sphereinabox/sixteen-nine-sao-2026/kicad/v1/sixteen-nine-sao/fab/bom.csv

Comment | Designator | Footprint | LCSC
LED | D1,DA1,DA2,DA3,DA4,DA5,DA6,DA7,DA8,DA9,DA10,DA11,DA12,DA13,DA14,DA15,DA16,DA17,DA18,DA19,DA20,DA21,DA22,DA23,DA24,DA25,DA26,DA27,DA28,DA29,DA30,DA31,DA32,DA33,DA34,DA35,DA36,DA37,DA38,DA39,DA40,DA41,DA42,DA43,DA44,DA45,DA46,DA47,DA48,DA49,DA50,DA51,DA52,DA53,DA54,DA55,DA56,DA57,DA58,DA59,DA60,DA61,DA62,DA63,DA64,DA65,DA66,DA67,DA68,DA69,DA70,DA71,DA72,DB1,DB2,DB3,DB4,DB5,DB6,DB7,DB8,DB9,DB10,DB11,DB12,DB13,DB14,DB15,DB16,DB17,DB18,DB19,DB20,DB21,DB22,DB23,DB24,DB25,DB26,DB27 | LED_SMD:LED_0603_1608Metric | C2290
LED | DB28,DB29,DB30,DB31,DB32,DB33,DB34,DB35,DB36,DB37,DB38,DB39,DB40,DB41,DB42,DB43,DB44,DB45,DB46,DB47,DB48,DB49,DB50,DB51,DB52,DB53,DB54,DB55,DB56,DB57,DB58,DB59,DB60,DB61,DB62,DB63,DB64,DB65,DB66,DB67,DB68,DB69,DB70,DB71,DB72 | LED_SMD:LED_0603_1608Metric | C2290
20k | R1,R4,R5,R6,R7,R8 | Resistor_SMD:R_0603_1608Metric | C4184
IS31FL3731-QF | U1 | Package_DFN_QFN:QFN-28-1EP_4x4mm_P0.4mm_EP2.3x2.3mm | C191206
100pF | C2,C5 | Capacitor_SMD:C_0402_1005Metric | C1546
150R | R9 | Resistor_SMD:R_0603_1608Metric | C22808
CH32V003F4U6 | U2 | Package_DFN_QFN:QFN-20-1EP_3x3mm_P0.4mm_EP1.65x1.65mm | C5299908
220pF | C1 | Capacitor_SMD:C_0402_1005Metric | C1530
10uF | C3,C4 | Capacitor_SMD:C_0603_1608Metric | C19702
100nF | C6 | Capacitor_SMD:C_0402_1005Metric | C1525
SW_Push | SW1,SW2 | Button_Switch_SMD:SW_SPST_TS-1088-xR020 | C720477
300R | R2,R3 | Resistor_SMD:R_0603_1608Metric | C23025
