sphereinabox/sixteen-nine-sao-2026/kicad/v1/sixteen-nine-sao/sixteen-nine-sao.csv

Reference | Qty | Value | LCSC | Footprint | Exclude from BOM | Exclude from Board | Exclude from Simulation | Exclude from Position Files | DNP
C1 | 1 | 220pF | C1530 | Capacitor_SMD:C_0402_1005Metric |  |  |  | ${EXCLUDE_FROM_POS_FILES}
C2,C5 | 2 | 100pF | C1546 | Capacitor_SMD:C_0402_1005Metric |  |  |  | ${EXCLUDE_FROM_POS_FILES}
C3,C4 | 2 | 10uF | C19702 | Capacitor_SMD:C_0603_1608Metric |  |  |  | ${EXCLUDE_FROM_POS_FILES}
C6 | 1 | 100nF | C1525 | Capacitor_SMD:C_0402_1005Metric |  |  |  | ${EXCLUDE_FROM_POS_FILES}
D1,DA1,DA2,DA3,DA4,DA5,DA6,DA7,DA8,DA9,DA10,DA11,DA12,DA13,DA14,DA15,DA16,DA17,DA18,DA19,DA20,DA21,DA22,DA23,DA24,DA25,DA26,DA27,DA28,DA29,DA30,DA31,DA32,DA33,DA34,DA35,DA36,DA37,DA38,DA39,DA40,DA41,DA42,DA43,DA44,DA45,DA46,DA47,DA48,DA49,DA50,DA51,DA52,DA53,DA54,DA55,DA56,DA57,DA58,DA59,DA60,DA61,DA62,DA63,DA64,DA65,DA66,DA67,DA68,DA69,DA70,DA71,DA72,DB1,DB2,DB3,DB4,DB5,DB6,DB7,DB8,DB9,DB10,DB11,DB12,DB13,DB14,DB15,DB16,DB17,DB18,DB19,DB20,DB21,DB22,DB23,DB24,DB25,DB26,DB27,DB28,DB29,DB30,DB31,DB32,DB33,DB34,DB35,DB36,DB37,DB38,DB39,DB40,DB41,DB42,DB43,DB44,DB45,DB46,DB47,DB48,DB49,DB50,DB51,DB52,DB53,DB54,DB55,DB56,DB57,DB58,DB59,DB60,DB61,DB62,DB63,DB64,DB65,DB66,DB67,DB68,DB69,DB70,DB71,DB72 | 145 | LED | C2290 | LED_SMD:LED_0603_1608Metric |  |  |  | ${EXCLUDE_FROM_POS_FILES}
J1 | 1 | Conn_02x03_Odd_Even |  | Connector_IDC:IDC-Header_2x03_P2.54mm_Vertical |  |  |  | ${EXCLUDE_FROM_POS_FILES} | DNP
J3 | 1 | Conn_01x06_Pin |  | Connector_PinHeader_2.00mm:PinHeader_1x06_P2.00mm_Vertical |  |  |  | ${EXCLUDE_FROM_POS_FILES} | DNP
R1,R4,R5,R6,R7,R8 | 6 | 20k | C4184 | Resistor_SMD:R_0603_1608Metric |  |  |  | ${EXCLUDE_FROM_POS_FILES}
R2,R3 | 2 | 300R | C23025 | Resistor_SMD:R_0603_1608Metric |  |  |  | ${EXCLUDE_FROM_POS_FILES}
R9 | 1 | 150R | C22808 | Resistor_SMD:R_0603_1608Metric |  |  |  | ${EXCLUDE_FROM_POS_FILES}
SW1,SW2 | 2 | SW_Push | C720477 | Button_Switch_SMD:SW_SPST_TS-1088-xR020 |  |  |  | ${EXCLUDE_FROM_POS_FILES}
U1 | 1 | IS31FL3731-QF | C191206 | Package_DFN_QFN:QFN-28-1EP_4x4mm_P0.4mm_EP2.3x2.3mm |  |  |  | ${EXCLUDE_FROM_POS_FILES}
U2 | 1 | CH32V003F4U6 | C5299908 | Package_DFN_QFN:QFN-20-1EP_3x3mm_P0.4mm_EP1.65x1.65mm |  |  |  | ${EXCLUDE_FROM_POS_FILES}
