sphereinabox/sixteen-nine-sao-2026/kicad/v1/schematic.pdf

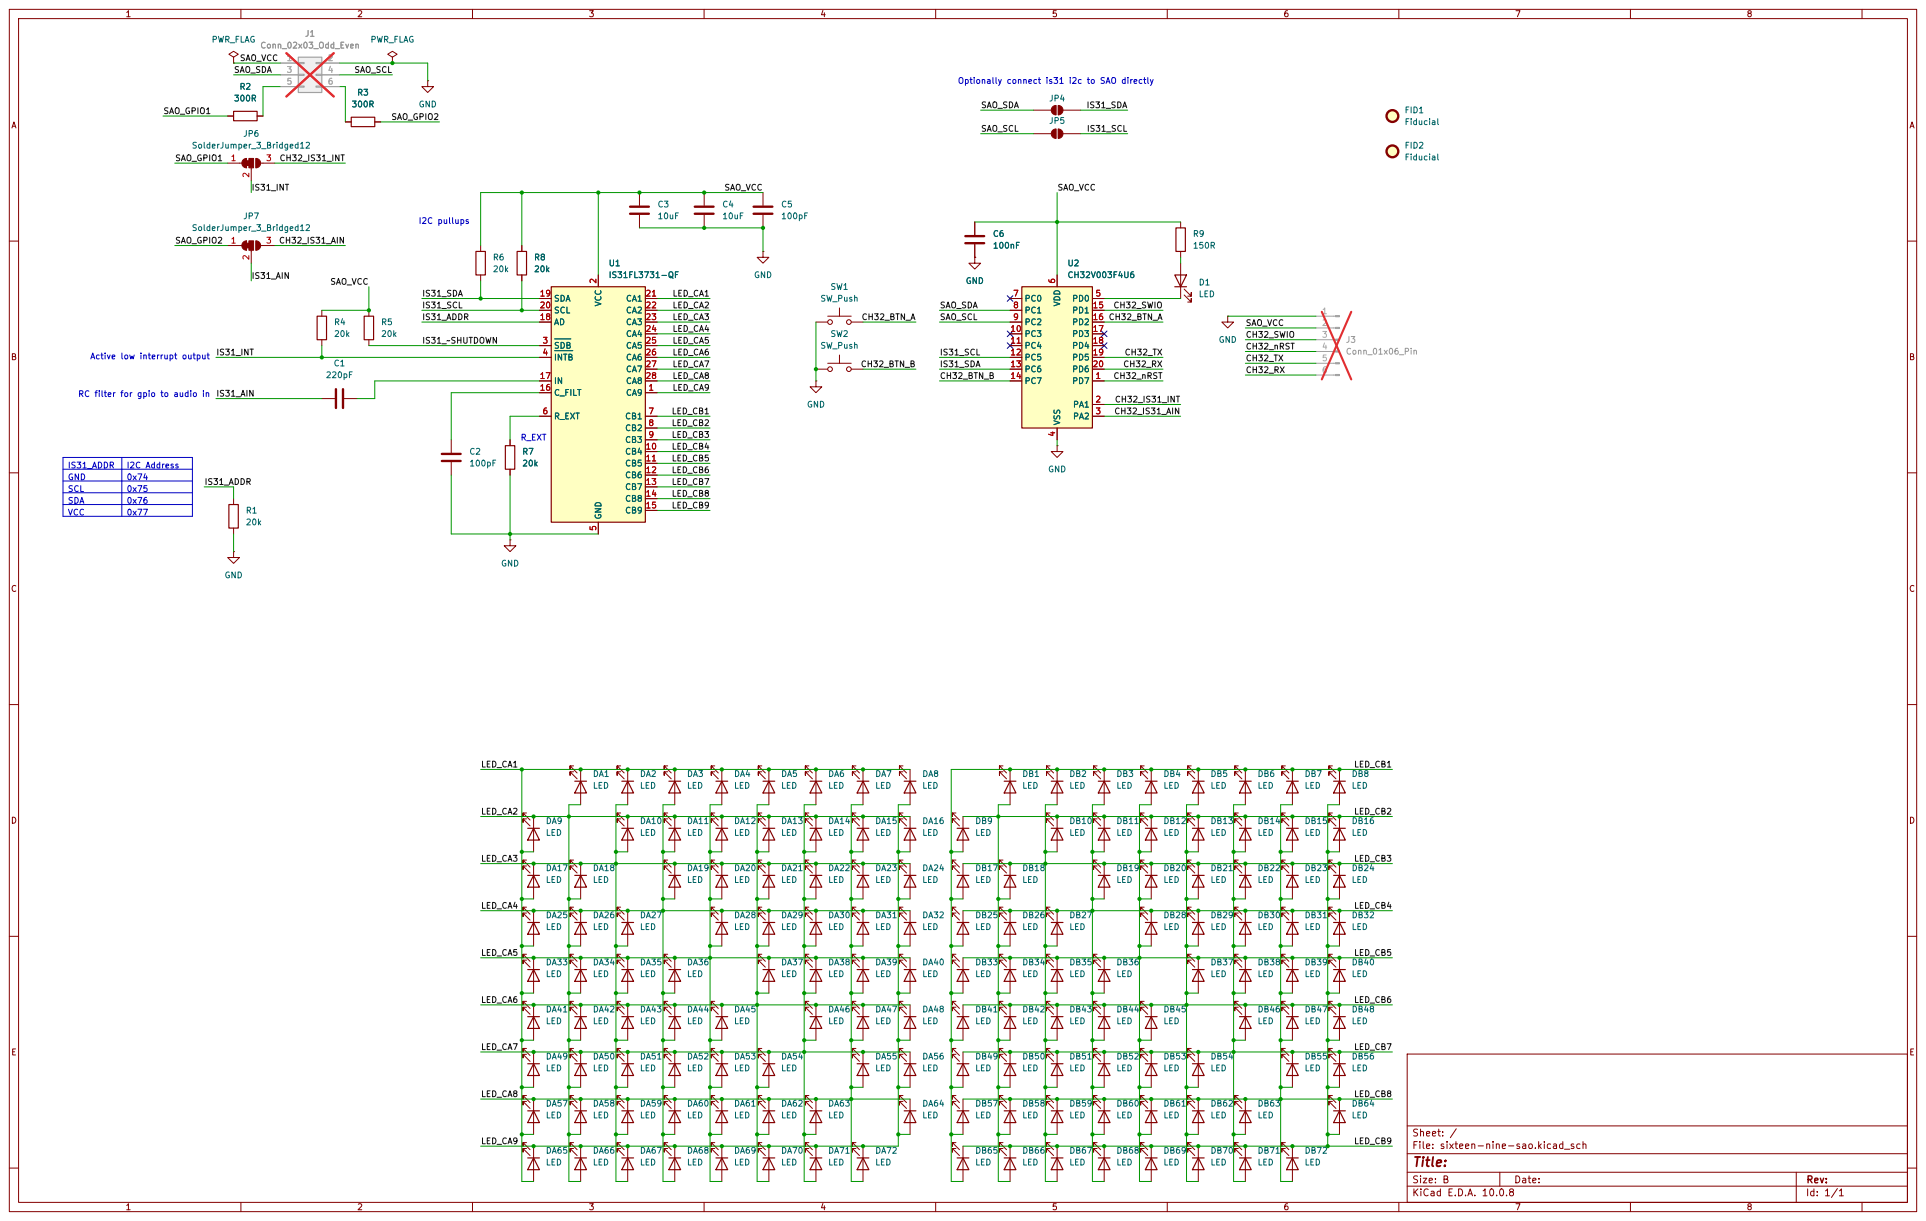
[picture p3: page 1]

IS31_ADDR | I2C Address GND 0x74

SCL | 0x75
SDA | 0x76

Sheet: /
File: sixteen-nine-sao.kicad_sch
Title:

Size: B | Rev:
KiCad E.D.A. 10.0.8 | Id: 1/1
