sphereinabox/sixteen-nine-sao-2026/kicad/v1/sixteen-nine-sao.pdf

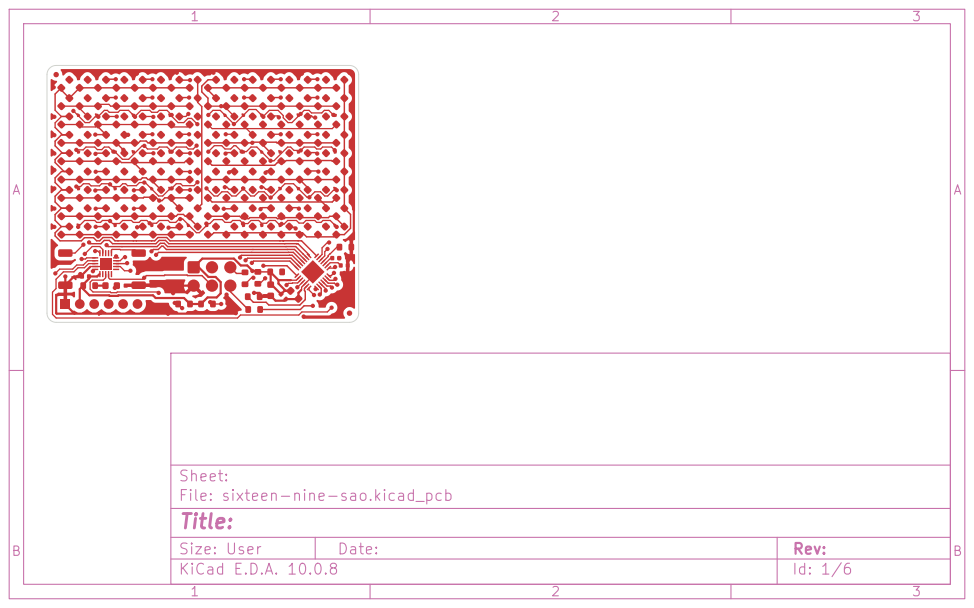
[picture p4: page 1]

Sheet:
File: sixteen-nine-sao.kicad_pcb
Title:

Size: User | Rev:

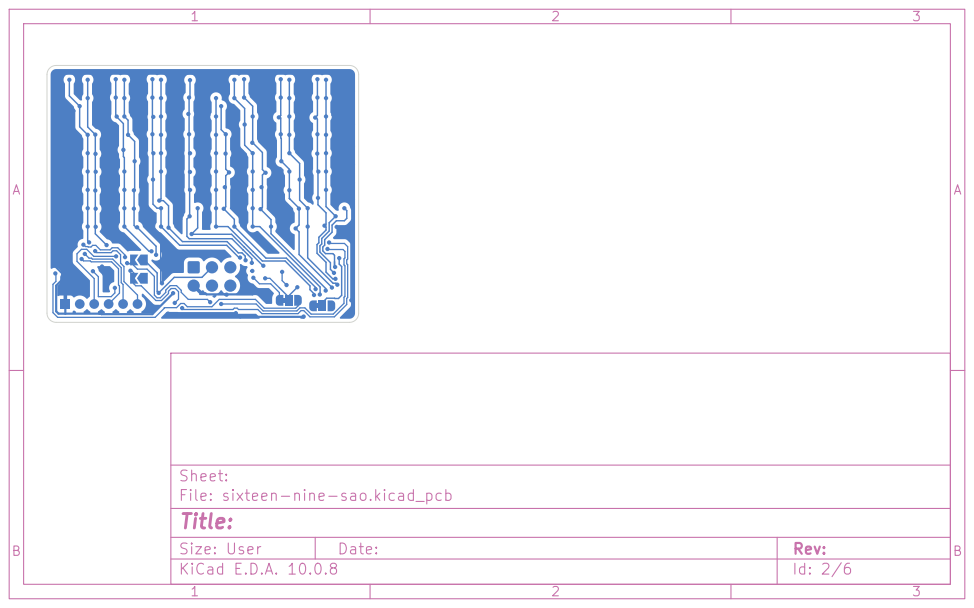
[picture p5: page 2]

Sheet:
File: sixteen-nine-sao.kicad_pcb
Title:

Size: User | Rev:

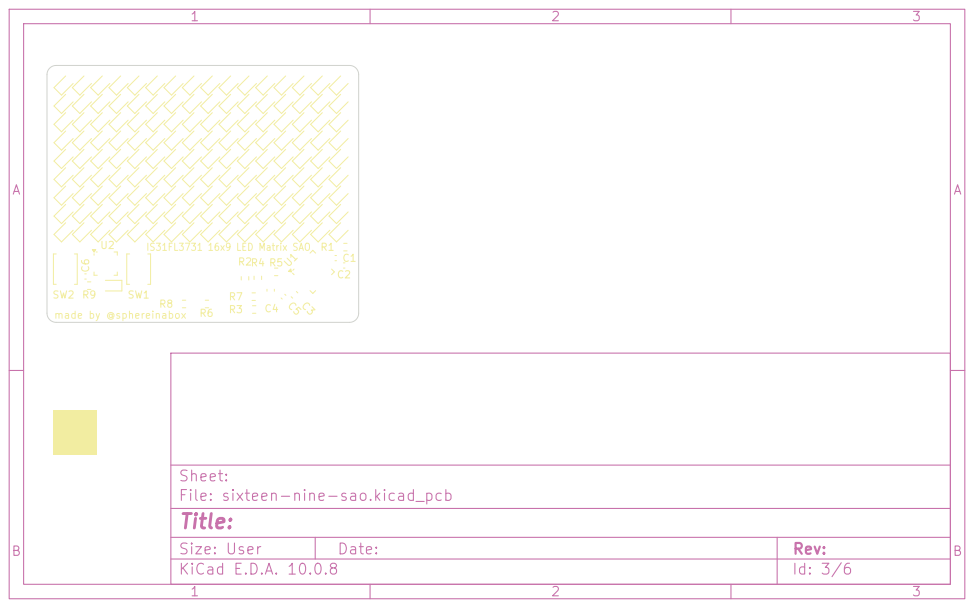
[picture p6: page 3]

Sheet:
File: sixteen-nine-sao.kicad_pcb
Title:

Size: User | Rev:

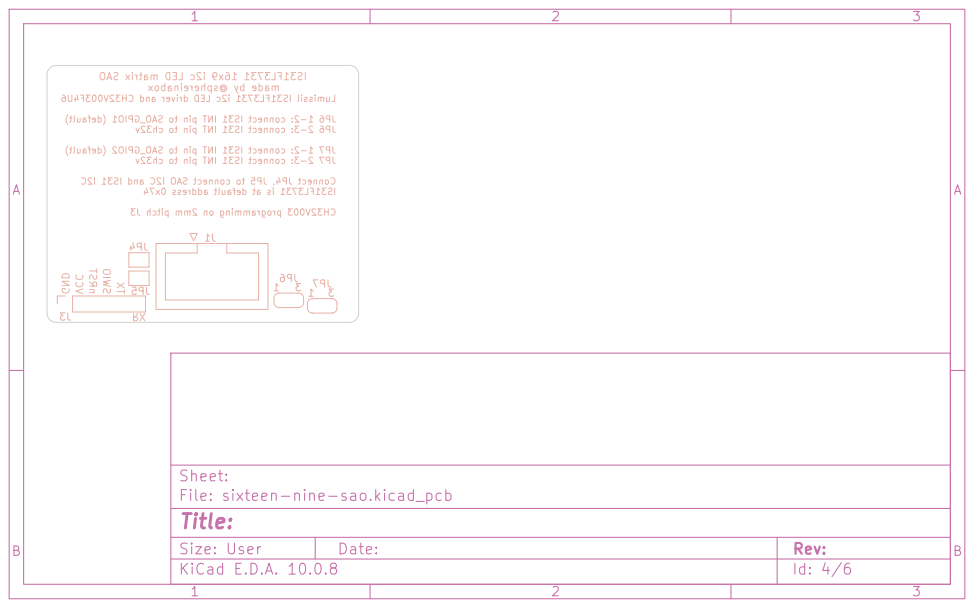
[picture p7: page 4]

Sheet:
File: sixteen-nine-sao.kicad_pcb
Title:

Size: User | Rev:

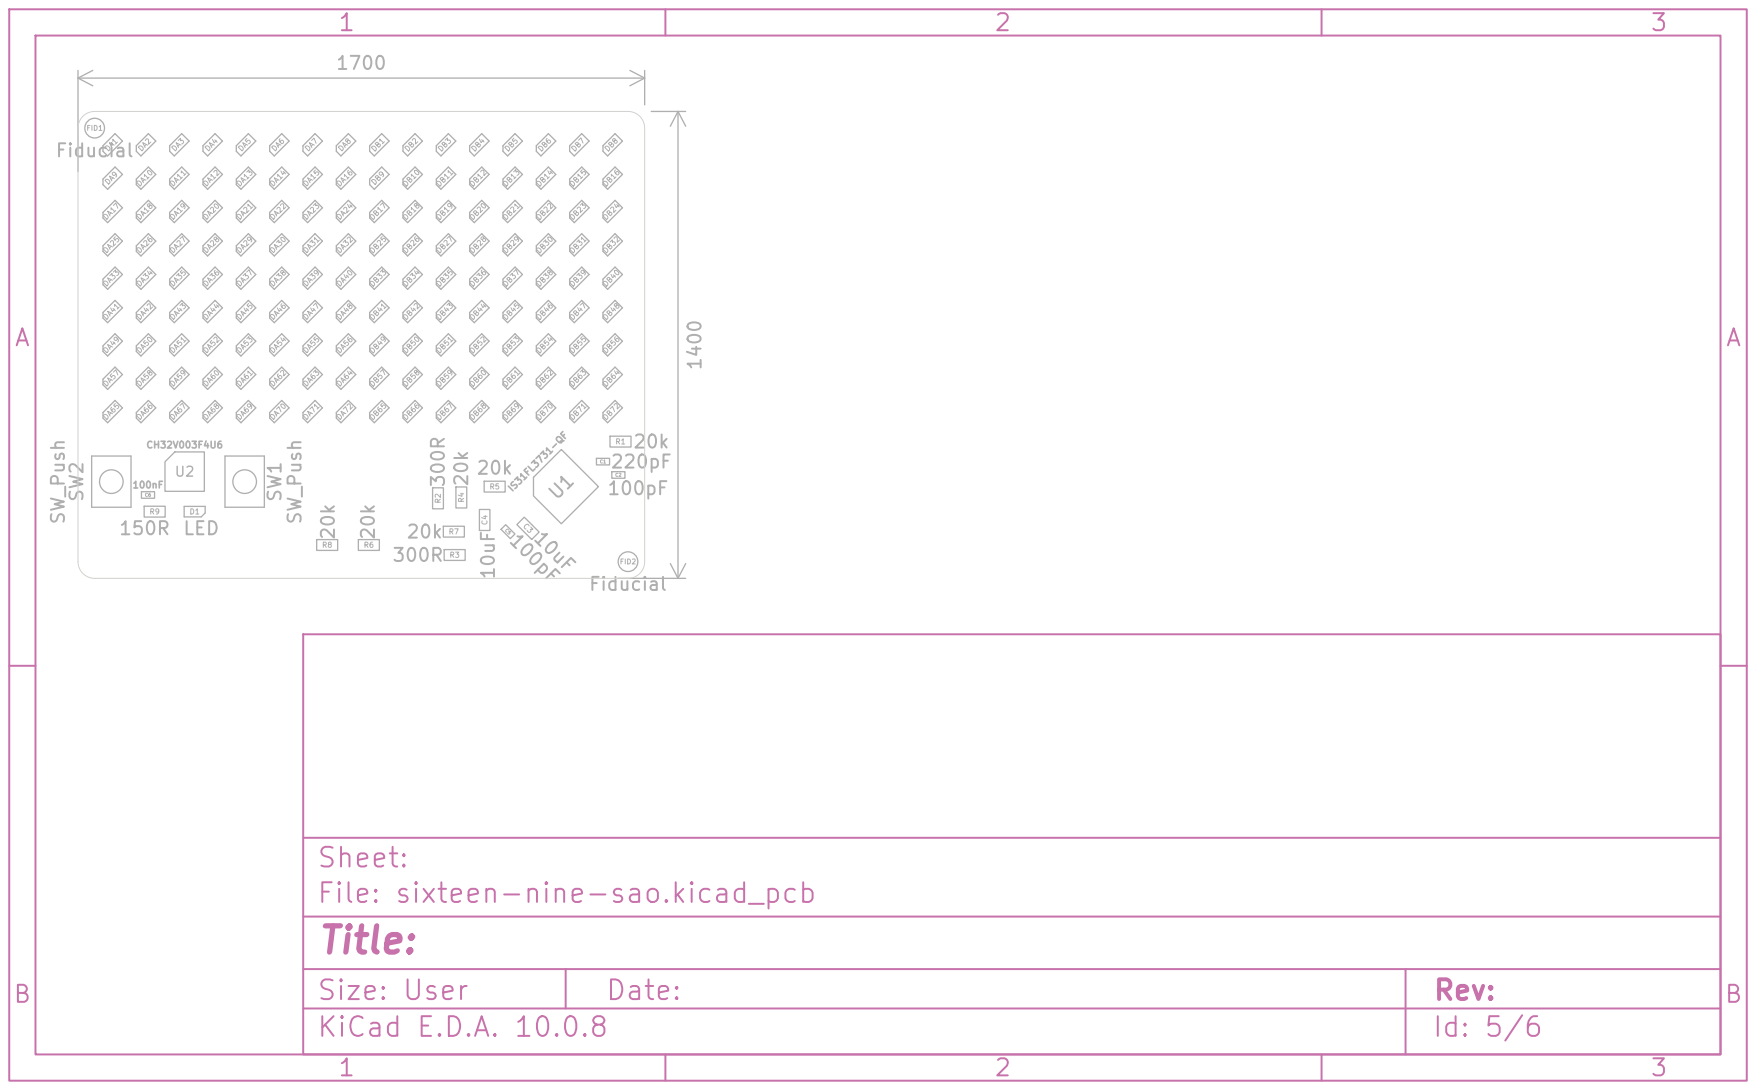
[picture p8: page 5]

Sheet:
File: sixteen-nine-sao.kicad_pcb
Title:

Size: User | Rev:

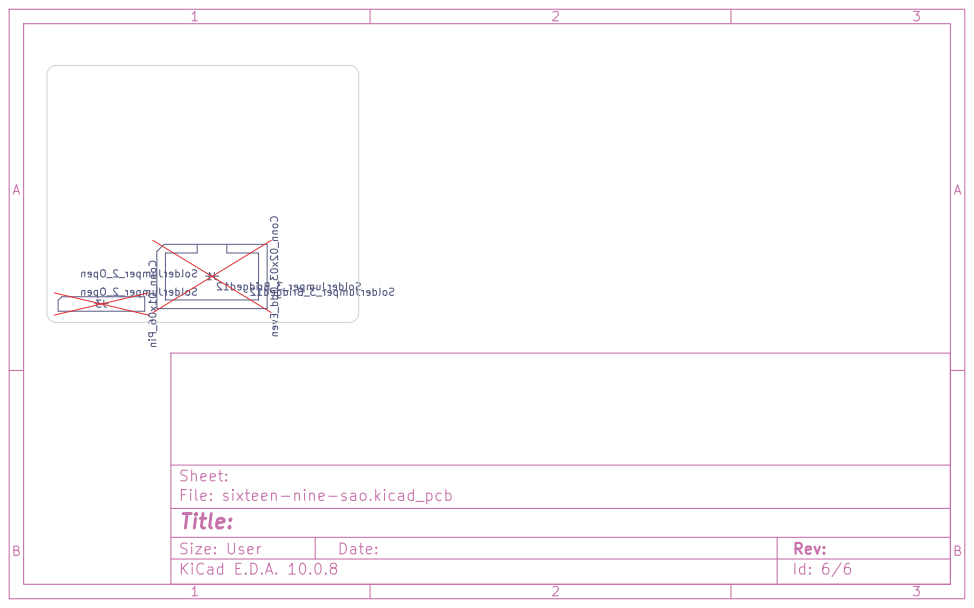
[picture p9: page 6]

Sheet:
File: sixteen-nine-sao.kicad_pcb
Title:

Size: User | Rev:
