sphereinabox/sixteen-nine-sao-2026/kicad/v1/sixteen-nine-sao/sixteen-nine-sao.kicad_pcb

## KiCad design kicad/v1/sixteen-nine-sao/sixteen-nine-sao.kicad_pcb (2026-11-01)

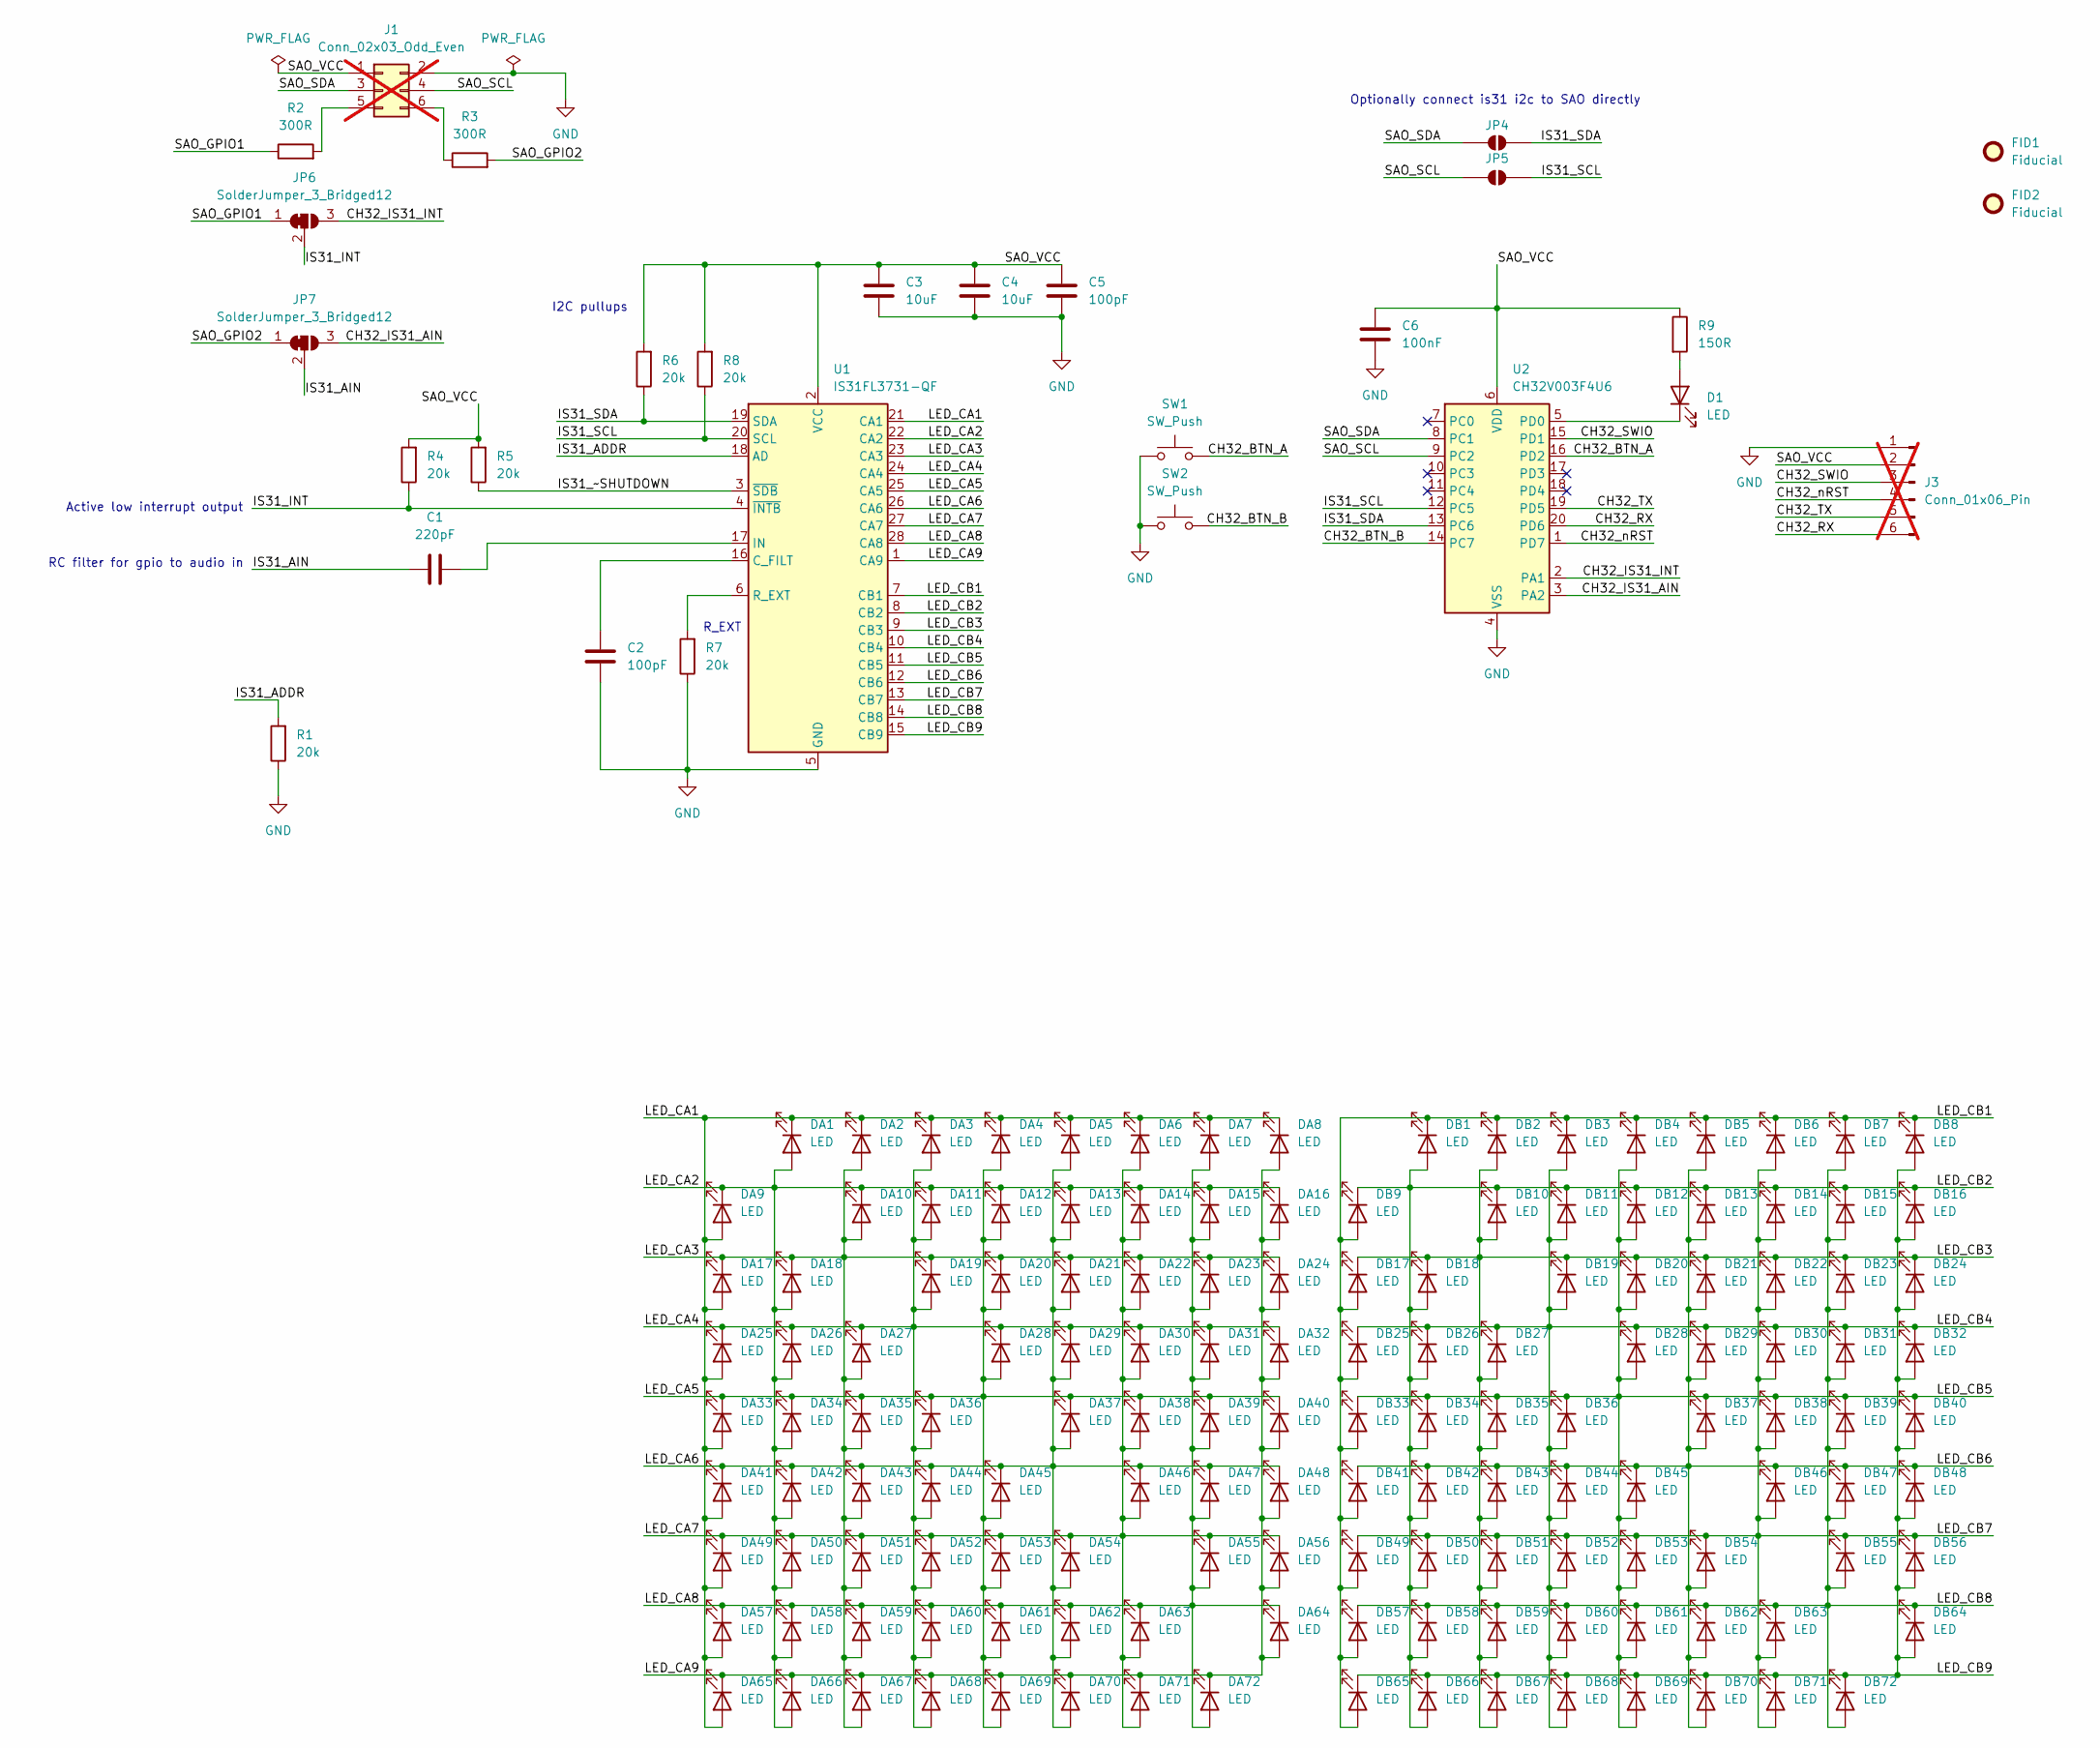
[picture p10: schematic sixteen-nine-sao.kicad_sch]

Parts:
C1: 220pF; C_0402_1005Metric; LCSC C1530
C2, C5: 100pF; C_0402_1005Metric; LCSC C1546
C3, C4: 10uF; C_0603_1608Metric; LCSC C19702
C6: 100nF; C_0402_1005Metric; LCSC C1525
D1: LED; LED_0603_1608Metric; LCSC C2290
DA1, DA2, DA3, DA4, DA5, DA6, DA7, DA8, DA9, DA10, DA11, DA12, DA13, DA14, DA15, DA16, DA17, DA18, DA19, DA20, DA21, DA22, DA23, DA24, DA25, DA26, DA27, DA28, DA29, DA30, DA31, DA32, DA33, DA34, DA35, DA36, DA37, DA38, DA39, DA40, DA41, DA42, DA43, DA44, DA45, DA46, DA47, DA48, DA49, DA50, DA51, DA52, DA53, DA54, DA55, DA56, DA57, DA58, DA59, DA60, DA61, DA62, DA63, DA64, DA65, DA66, DA67, DA68, DA69, DA70, DA71, DA72: LED; LED_0603_1608Metric; LCSC C2290
DB1, DB2, DB3, DB4, DB5, DB6, DB7, DB8, DB9, DB10, DB11, DB12, DB13, DB14, DB15, DB16, DB17, DB18, DB19, DB20, DB21, DB22, DB23, DB24, DB25, DB26, DB27, DB28, DB29, DB30, DB31, DB32, DB33, DB34, DB35, DB36, DB37, DB38, DB39, DB40, DB41, DB42, DB43, DB44, DB45, DB46, DB47, DB48, DB49, DB50, DB51, DB52, DB53, DB54, DB55, DB56, DB57, DB58, DB59, DB60, DB61, DB62, DB63, DB64, DB65, DB66, DB67, DB68, DB69, DB70, DB71, DB72: LED; LED_0603_1608Metric; LCSC C2290
FID1, FID2: Fiducial; Fiducial_0.75mm_Mask1.5mm
J1: Conn_02x03_Odd_Even; IDC-Header_2x03_P2.54mm_Vertical; not fitted
J3: Conn_01x06_Pin; PinHeader_1x06_P2.00mm_Vertical; not fitted
JP4, JP5: SolderJumper_2_Open; SolderJumper-2_P1.3mm_Open_TrianglePad1.0x1.5mm
JP6, JP7: SolderJumper_3_Bridged12; SolderJumper-3_P1.3mm_Bridged12_RoundedPad1.0x1.5mm_NumberL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
R1, R4, R5, R6, R7, R8: 20k; R_0603_1608Metric; LCSC C4184
R2, R3: 300R; R_0603_1608Metric; LCSC C23025
R9: 150R; R_0603_1608Metric; LCSC C22808
SW1, SW2: SW_Push; SW_SPST_TS-1088-xR020; LCSC C720477
U1: IS31FL3731-QF; QFN-28-1EP_4x4mm_P0.4mm_EP2.3x2.3mm; LCSC C191206
U2: CH32V003F4U6; QFN-20-1EP_3x3mm_P0.4mm_EP1.65x1.65mm; LCSC C5299908

Connections:
/CH32_BTN_A: SW1.2, U2.16 (PD2)
/CH32_BTN_B: SW2.2, U2.14 (PC7)
/CH32_IS31_AIN: JP7.3 (B), U2.3 (PA2)
/CH32_IS31_INT: JP6.3 (B), U2.2 (PA1)
/CH32_RX: J3.6, U2.20 (PD6)
/CH32_SWIO: J3.3, U2.15 (PD1)
/CH32_TX: J3.5, U2.19 (PD5)
/CH32_nRST: J3.4, U2.1 (PD7)
/IS31_ADDR: R1.2, U1.18 (AD)
/IS31_AIN: C1.1, JP7.2 (C)
/IS31_INT: JP6.2 (C), R4.1, U1.4 (~INTB)
/IS31_SCL: JP5.2 (B), R8.1, U1.20 (SCL), U2.12 (PC5)
/IS31_SDA: JP4.2 (B), R6.1, U1.19 (SDA), U2.13 (PC6)
/IS31_~SHUTDOWN: R5.1, U1.3 (~SDB)
/LED_CA1: DA1.1 (K), DA2.1 (K), DA3.1 (K), DA4.1 (K), DA5.1 (K), DA6.1 (K), DA7.1 (K), DA8.1 (K), DA9.2 (A), DA17.2 (A), DA25.2 (A), DA33.2 (A), DA41.2 (A), DA49.2 (A), DA57.2 (A), DA65.2 (A), U1.21 (CA1)
/LED_CA2: DA1.2 (A), DA9.1 (K), DA10.1 (K), DA11.1 (K), DA12.1 (K), DA13.1 (K), DA14.1 (K), DA15.1 (K), DA16.1 (K), DA18.2 (A), DA26.2 (A), DA34.2 (A), DA42.2 (A), DA50.2 (A), DA58.2 (A), DA66.2 (A), U1.22 (CA2)
/LED_CA3: DA2.2 (A), DA10.2 (A), DA17.1 (K), DA18.1 (K), DA19.1 (K), DA20.1 (K), DA21.1 (K), DA22.1 (K), DA23.1 (K), DA24.1 (K), DA27.2 (A), DA35.2 (A), DA43.2 (A), DA51.2 (A), DA59.2 (A), DA67.2 (A), U1.23 (CA3)
/LED_CA4: DA3.2 (A), DA11.2 (A), DA19.2 (A), DA25.1 (K), DA26.1 (K), DA27.1 (K), DA28.1 (K), DA29.1 (K), DA30.1 (K), DA31.1 (K), DA32.1 (K), DA36.2 (A), DA44.2 (A), DA52.2 (A), DA60.2 (A), DA68.2 (A), U1.24 (CA4)
/LED_CA5: DA4.2 (A), DA12.2 (A), DA20.2 (A), DA28.2 (A), DA33.1 (K), DA34.1 (K), DA35.1 (K), DA36.1 (K), DA37.1 (K), DA38.1 (K), DA39.1 (K), DA40.1 (K), DA45.2 (A), DA53.2 (A), DA61.2 (A), DA69.2 (A), U1.25 (CA5)
/LED_CA6: DA5.2 (A), DA13.2 (A), DA21.2 (A), DA29.2 (A), DA37.2 (A), DA41.1 (K), DA42.1 (K), DA43.1 (K), DA44.1 (K), DA45.1 (K), DA46.1 (K), DA47.1 (K), DA48.1 (K), DA54.2 (A), DA62.2 (A), DA70.2 (A), U1.26 (CA6)
/LED_CA7: DA6.2 (A), DA14.2 (A), DA22.2 (A), DA30.2 (A), DA38.2 (A), DA46.2 (A), DA49.1 (K), DA50.1 (K), DA51.1 (K), DA52.1 (K), DA53.1 (K), DA54.1 (K), DA55.1 (K), DA56.1 (K), DA63.2 (A), DA71.2 (A), U1.27 (CA7)
/LED_CA8: DA7.2 (A), DA15.2 (A), DA23.2 (A), DA31.2 (A), DA39.2 (A), DA47.2 (A), DA55.2 (A), DA57.1 (K), DA58.1 (K), DA59.1 (K), DA60.1 (K), DA61.1 (K), DA62.1 (K), DA63.1 (K), DA64.1 (K), DA72.2 (A), U1.28 (CA8)
/LED_CA9: DA8.2 (A), DA16.2 (A), DA24.2 (A), DA32.2 (A), DA40.2 (A), DA48.2 (A), DA56.2 (A), DA64.2 (A), DA65.1 (K), DA66.1 (K), DA67.1 (K), DA68.1 (K), DA69.1 (K), DA70.1 (K), DA71.1 (K), DA72.1 (K), U1.1 (CA9)
/LED_CB1: DB1.1 (K), DB2.1 (K), DB3.1 (K), DB4.1 (K), DB5.1 (K), DB6.1 (K), DB7.1 (K), DB8.1 (K), DB9.2 (A), DB17.2 (A), DB25.2 (A), DB33.2 (A), DB41.2 (A), DB49.2 (A), DB57.2 (A), DB65.2 (A), U1.7 (CB1)
/LED_CB2: DB1.2 (A), DB9.1 (K), DB10.1 (K), DB11.1 (K), DB12.1 (K), DB13.1 (K), DB14.1 (K), DB15.1 (K), DB16.1 (K), DB18.2 (A), DB26.2 (A), DB34.2 (A), DB42.2 (A), DB50.2 (A), DB58.2 (A), DB66.2 (A), U1.8 (CB2)
/LED_CB3: DB2.2 (A), DB10.2 (A), DB17.1 (K), DB18.1 (K), DB19.1 (K), DB20.1 (K), DB21.1 (K), DB22.1 (K), DB23.1 (K), DB24.1 (K), DB27.2 (A), DB35.2 (A), DB43.2 (A), DB51.2 (A), DB59.2 (A), DB67.2 (A), U1.9 (CB3)
/LED_CB4: DB3.2 (A), DB11.2 (A), DB19.2 (A), DB25.1 (K), DB26.1 (K), DB27.1 (K), DB28.1 (K), DB29.1 (K), DB30.1 (K), DB31.1 (K), DB32.1 (K), DB36.2 (A), DB44.2 (A), DB52.2 (A), DB60.2 (A), DB68.2 (A), U1.10 (CB4)
/LED_CB5: DB4.2 (A), DB12.2 (A), DB20.2 (A), DB28.2 (A), DB33.1 (K), DB34.1 (K), DB35.1 (K), DB36.1 (K), DB37.1 (K), DB38.1 (K), DB39.1 (K), DB40.1 (K), DB45.2 (A), DB53.2 (A), DB61.2 (A), DB69.2 (A), U1.11 (CB5)
/LED_CB6: DB5.2 (A), DB13.2 (A), DB21.2 (A), DB29.2 (A), DB37.2 (A), DB41.1 (K), DB42.1 (K), DB43.1 (K), DB44.1 (K), DB45.1 (K), DB46.1 (K), DB47.1 (K), DB48.1 (K), DB54.2 (A), DB62.2 (A), DB70.2 (A), U1.12 (CB6)
/LED_CB7: DB6.2 (A), DB14.2 (A), DB22.2 (A), DB30.2 (A), DB38.2 (A), DB46.2 (A), DB49.1 (K), DB50.1 (K), DB51.1 (K), DB52.1 (K), DB53.1 (K), DB54.1 (K), DB55.1 (K), DB56.1 (K), DB63.2 (A), DB71.2 (A), U1.13 (CB7)
/LED_CB8: DB7.2 (A), DB15.2 (A), DB23.2 (A), DB31.2 (A), DB39.2 (A), DB47.2 (A), DB55.2 (A), DB57.1 (K), DB58.1 (K), DB59.1 (K), DB60.1 (K), DB61.1 (K), DB62.1 (K), DB63.1 (K), DB64.1 (K), DB72.2 (A), U1.14 (CB8)
/LED_CB9: DB8.2 (A), DB16.2 (A), DB24.2 (A), DB32.2 (A), DB40.2 (A), DB48.2 (A), DB56.2 (A), DB64.2 (A), DB65.1 (K), DB66.1 (K), DB67.1 (K), DB68.1 (K), DB69.1 (K), DB70.1 (K), DB71.1 (K), DB72.1 (K), U1.15 (CB9)
/SAO_GPIO1: JP6.1 (A), R2.1
/SAO_GPIO2: JP7.1 (A), R3.2
/SAO_SCL: J1.4, JP5.1 (A), U2.9 (PC2)
/SAO_SDA: J1.3, JP4.1 (A), U2.8 (PC1)
/SAO_VCC: C3.1, C4.1, C5.1, C6.1, J1.1, J3.2, R4.2, R5.2, R6.2, R8.2, R9.1, U1.2 (VCC), U2.6 (VDD)
GND: C2.2, C3.2, C4.2, C5.2, C6.2, J1.2, J3.1, R1.1, R7.1, SW1.1, SW2.1, U1.5 (GND), U1.29 (GND), U2.4 (VSS), U2.21 (VSS)
unnamed: D1.2 (A), R9.2
unnamed: D1.1 (K), U2.5 (PD0)
unnamed: J1.5, R2.2
unnamed: J1.6, R3.1
unnamed: C2.1, U1.16 (C_FILT)
unnamed: C1.2, U1.17 (IN)
unnamed: R7.2, U1.6 (R_EXT)

Notes on the sheet:
R_EXT
I2C pullups
RC filter for gpio to audio in
Optionally connect is31 i2c to SAO directly
Active low interrupt output

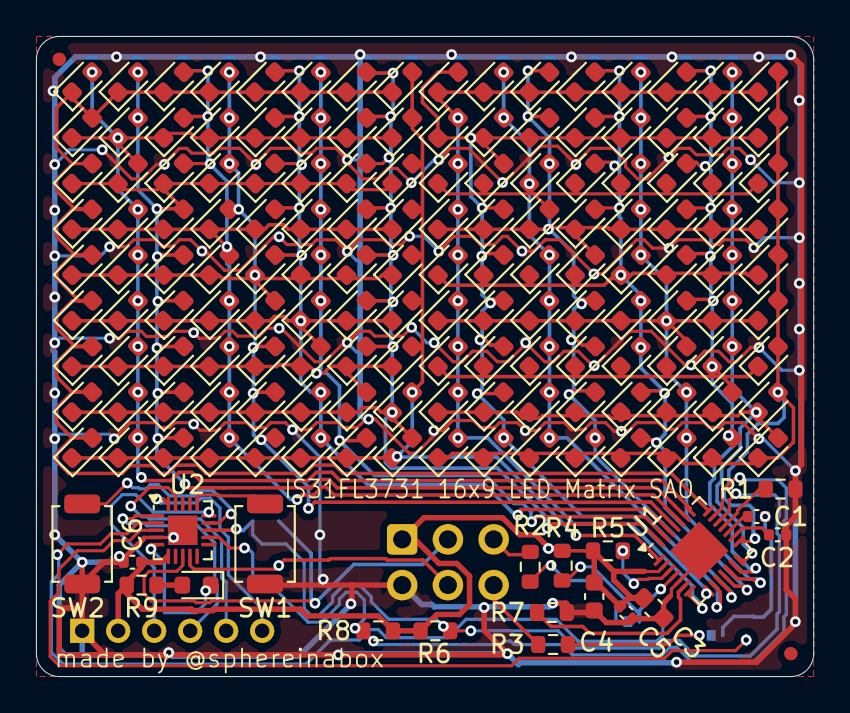
[picture p11: board sixteen-nine-sao.kicad_pcb from above]

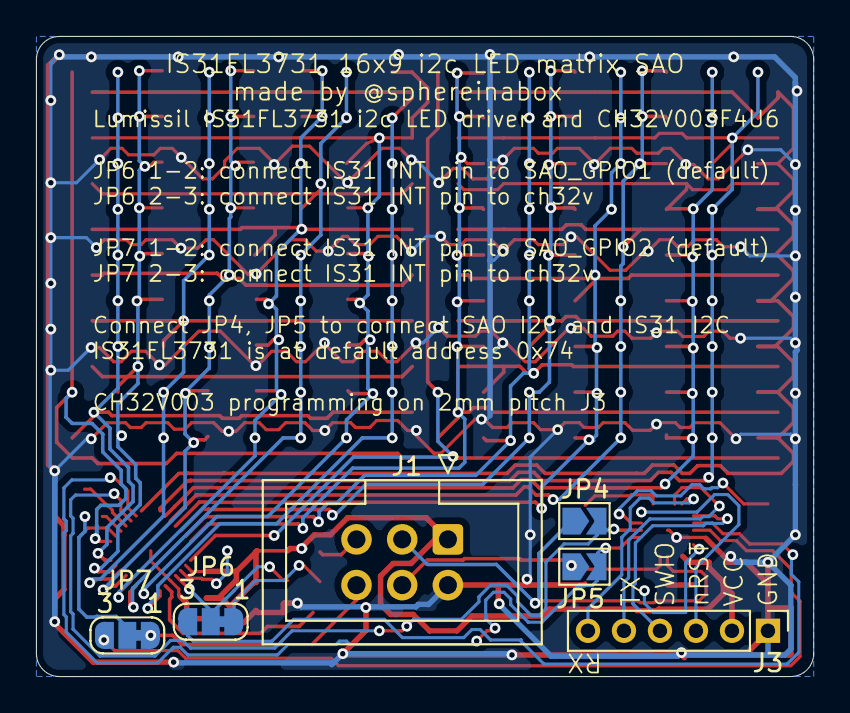
[picture p12: board sixteen-nine-sao.kicad_pcb from below]

Board: 2 copper layers, 43.2 x 35.6 mm, 172 parts (6 on the bottom side), 45 nets.
