sphereinabox/sixteen-nine-sao-2026/software/ch32/include/funconfig.h

#ifndef _FUNCONFIG_H
#define _FUNCONFIG_H

// Place configuration items here, you can see a full list in ch32fun/ch32fun.h
// To reconfigure to a different processor, update TARGET_MCU in the  Makefile

// lib_rand needs to be configured with how random you want it to produce data.
#define RANDOM_STRENGTH    2

#endif
