sphereinabox/sixteen-nine-sao-2026/software/ch32/examples/i2c_slave/i2c_slave.c

#include "ch32fun.h"
#include "i2c_slave.h"
#include <stdio.h>

// The I2C slave library uses a one byte address so you can extend the size of this array up to 256 registers
// note that the register set is modified by interrupts, to prevent the compiler from accidently optimizing stuff
// away make sure to declare the register array volatile

volatile uint8_t i2c_registers[3] = {0x00};

void onWrite(uint8_t reg, uint8_t length) {
    // Called from the interrupt when an I2C write operation completes
    // Put one-off operations involving changes to i2c_registers here,
    // but you can also just read i2c_registers from main().
}

int main() {
    SystemInit();
    funGpioInitAll();

    // Initialize I2C slave
    funPinMode(PC1, GPIO_CFGLR_OUT_10Mhz_AF_OD); // SDA
    funPinMode(PC2, GPIO_CFGLR_OUT_10Mhz_AF_OD); // SCL
    SetupI2CSlave(0x9, i2c_registers, sizeof(i2c_registers), onWrite, NULL, false);

    // Initialize LED
    funPinMode(PD0, GPIO_CFGLR_OUT_10Mhz_PP); // LED

    while (1) {
        funDigitalWrite(PD0, i2c_registers[0] & 1);
    }
}
