sphereinabox/sixteen-nine-sao-2026/software/ch32/examples/sao_animations/textscroll_font.c

#include "anim.h"

const uint8_t font_bitmap[] = {
    // // \r or unknown
    // '\r',
    // 0b11111110,
    // 0b10000010,
    // 0b11000110,
    // 0b10101010,
    // 0b10010010,
    // 0b10101010,
    // 0b11000110,
    // 0b10000010,
    // 0b11111110,
    // // space
    // ' ',
    // 0b00000000,
    // 0b00000000,
    // 0b00000000,
    // 0b00000000,
    // 0b00000000,
    // 0b00000000,
    // 0b00000000,
    // 0b00000000,
    // 0b00000000,
    // !
    '!',
    0b10000000,
    0b10000000,
    0b10000000,
    0b10000000,
    0b10000000,
    0b00000000,
    0b10000000,
    0b00000000,
    0b00000000,
    // "
    '\"',
    0b10100000,
    0b10100000,
    0b00000000,
    0b00000000,
    0b00000000,
    0b00000000,
    0b00000000,
    0b00000000,
    0b00000000,
    // #
    '#',
    0b01010000,
    0b11111000,
    0b01010000,
    0b01010000,
    0b11111000,
    0b01010000,
    0b01010000,
    0b00000000,
    0b00000000,
    // $
    '$',
    0b00100000,
    0b01110000,
    0b10001000,
    0b01000000,
    0b00100000,
    0b10010000,
    0b01100000,
    0b00100000,
    0b00000000,
    // %
    '%',
    0b01000010,
    0b10100100,
    0b01001000,
    0b00010000,
    0b00100000,
    0b01001000,
    0b10010100,
    0b00001000,
    0b00000000,
    // &
    '&',
    0b01100000,
    0b10000000,
    0b01000000,
    0b10101000,
    0b10010000,
    0b10011000,
    0b01100000,
    0b00000000,
    0b00000000,
    // '
    '\'',
    0b10000000,
    0b10000000,
    0b00000000,
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
    0b00000000,
    0b01100100,
    0b10011000,
    0b00000000,
    0b00000000,
    0b00000000,
    0b00000000,
    // end sentinel value
    '\0',
    0b00000000,
    0b00000000,
    0b00000000,
    0b00000000,
    0b00000000,
    0b00000000,
    0b00000000,
    0b00000000,
    0b00000000
};
