sphereinabox/sixteen-nine-sao-2026/software/badge_micropython/sixteennine_examples.py

## to install micropython library, copy sixteenninesaoch32.py to badge "lib" folder
## then in your code add code like the examples below:

# if you need different i2c:
## Initialize I2C peripherals
# from machine import I2C, Pin
# I2C0_SDA = Pin(0)
# I2C0_SCL = Pin(1)
# i2c0 = I2C(0, sda=I2C0_SDA, scl=I2C0_SCL, freq=400_000)

from lib.sixteenninesaoch32 import *
# supercon 8 SAO set up i2c0 and i2c1 in boot.py
# sao = SixteenNineSaoCh32V1(i2c0)

# 2026 supercon X badge:
# I had to edit line 38 of lib/sao.py to become:
#     def readfrom(self, nbytes, stop=True):
from sao import i2c
sao = SixteenNineSaoCh32V1(i2c)

## SAO examples follow:
# sao.led_set(1) # led on
# sao.led_set(0) # led off

# print(sao.buttons_get())
# if sao.buttons_get() & 0x1:
#     print('Right button pressed')
# if sao.buttons_get() & 0x2:
#     print('Left button pressed')

## set animation max intensity
# sao.max_intensity_set(255) # max intensity
# sao.max_intensity_set(64) # default intensity

### switch to different animations:

## conway's game of life
# sao.anim_set(SAO_ANIMATION_CHOICE_CONWAYS)

## plasma animation
# sao.anim_set(SAO_ANIMATION_CHOICE_PLASMA)

## bouncing box animation
# sao.anim_set(SAO_ANIMATION_CHOICE_BOUNCE)

## set static fixed display
pixeldata = bytearray([
    #  0     1     2     3     4     5     6     7     8     9    10    11    12    13    14    15
    0x00, 0x00, 0x00, 0x00, 0x00, 0x00, 0x00, 0x00, 0x00, 0x00, 0x00, 0x00, 0x00, 0x00, 0x00, 0x00,
    0x00, 0x00, 0x00, 0x00, 0x00, 0x00, 0x00, 0x00, 0x00, 0x00, 0x00, 0x00, 0x00, 0x00, 0x00, 0x00,
    0x00, 0x00, 0x00, 0x00, 0x00, 0x00, 0x00, 0x00, 0x00, 0x00, 0x00, 0x00, 0x00, 0x00, 0x00, 0x00,
    0x00, 0x00, 0x00, 0x00, 0x00, 0x00, 0x00, 0x00, 0x00, 0x00, 0x00, 0x00, 0x00, 0x00, 0x00, 0x00,
    0x00, 0x00, 0x00, 0x00, 0x00, 0x00, 0x00, 0x00, 0x00, 0x00, 0x00, 0x00, 0x00, 0x00, 0x00, 0x00,
    0x00, 0x00, 0x00, 0x00, 0x00, 0x00, 0x00, 0x00, 0x00, 0x00, 0x00, 0x00, 0x00, 0x00, 0x00, 0x00,
    0x00, 0x00, 0x00, 0x00, 0x00, 0x00, 0x00, 0x00, 0x00, 0x00, 0x00, 0x00, 0x00, 0x00, 0x00, 0x00,
    0x00, 0x00, 0x00, 0x00, 0x00, 0x00, 0x00, 0x00, 0x00, 0x00, 0x00, 0x00, 0x00, 0x00, 0x00, 0x00,
    0x00, 0x00, 0x00, 0x00, 0x00, 0x00, 0x00, 0x00, 0x00, 0x00, 0x00, 0x00, 0x00, 0x00, 0x00, 0x00
    ])
# checkerboard pattern:
for row in range(9):
    for col in range(16):
        if (row + col) & 1:
            pixeldata[row*16+col] = 64
# sao.static_display_set(pixeldata)

## set SAO scrolling text
# sao.scrolling_text_set('Hello World!')
### newlines in text are supported.
### The SAO waits for the text before newline to scroll off before resuming after newline
# sao.scrolling_text_set('One\nTwo\nThree')
