sphereinabox/sixteen-nine-sao-2026/(commit log)

2026-11-01 add kicad files
    [bom.csv, sixteen-nine-sao.csv, sixteen-nine-sao.kicad_pcb, sixteen-nine-sao.kicad_sch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]
2026-11-01 switch platform to github URL so users don't need to manually install it
2026-11-03 Turn off directly-controlled LED
2026-11-03 Restart conways from new random seed after 500 generations so doesn't get stuck with gliders
    [anim_conways.c]
2026-11-04 Add micropython examples to run is31fl3731 directly when solder jumpers are closed.
2026-11-04 Don't drive display when JP4/JP5 are closed. Blink LED twice to indicate status.
2026-11-04 Start adding i2c slave support
2026-11-04 run bitbang i2c faster
2026-11-04 Add support for printing multiple newline-separated strings
2026-11-04 i2c header fix. more button support
    [board.h, sao_anim_main.c]
2026-11-05 Switch animation from i2c
2026-11-05 Set animation max intensity over i2c
2026-11-06 i2c command for changing text
